kietanhtran/PZEM004T_Arduino_Energy_Monitor/word/bia.docx

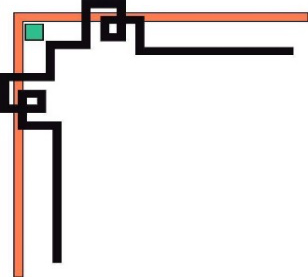
[picture p36: figure]
CRNRC057
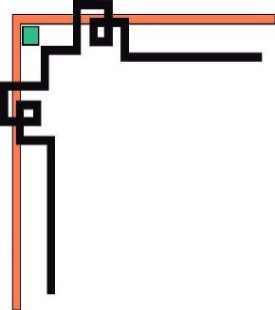
[picture p37: figure]
CRNRC057

TRƯỜNG ĐẠI HỌC SƯ PHẠM KỸ THUẬT TP. HCM

KHOA ĐÀO TẠO CHẤT LƯỢNG CAO

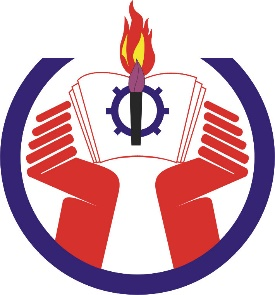
[picture p38: figure]
logo-truong

ĐỒ ÁN MÔN HỌC

THIẾT KẾ VÀ THI CÔNG

HỆ THỐNG ĐO VÀ GIÁM SÁT ĐIỆN NĂNG

SVTH: TRẦN ANH KIỆT

MSSV: 15141033

Khóa: 2015

Ngành: ĐIỆN TỬ CÔNG NGHIỆP

GVHD: ThS. TRƯƠNG NGỌC ANH

Tp. Hồ Chí Minh, tháng 1 năm 2019
