kietanhtran/PZEM004T_Arduino_Energy_Monitor/word/Muc Luc.docx

MỤC LỤC

Trang phụ bìa TRANG

Nhiệm vụ đồ án môn học i

Trang phiếu nhận xét của giáo viên hướng dẫn ii

Trang phiếu nhận xét của giáo viên phản biện iii

Lời cảm ơn iv

Tóm tắt v

Mục lục vi

Danh mục các từ viết tắt viii

Danh mục các bảng biểu ix

Danh mục các hình ảnh, biểu đồ x
