kietanhtran/PZEM004T_Arduino_Energy_Monitor/(list of files, drawings)

Other design files:
mach_in/PCB1.PcbDoc
mach_in/PCB_Project1_DOAN2.PrjPCB
mach_in/SCHE.SchDoc
